C44Supra/Lily58/(commit log)

2019-08-20 Fixed gaps in copper fills
    [Lily58_Pro.kicad_pcb]
2019-08-20 Replaced SW25 with Rotary Encoder. Takes place of SW25 in matrix
    Removed the footprint for switch 25 and replaced it with an Alps EC11E encoder. Encoder outputs have been connected to A3(PF4) and A2(PF5). The switch part of the encoder connects to the old spot of SW25 in the matrix. I've used a modified version of the footprint Keeb.io made for this particular encoder and added it to the lily58 footprint library. Also plotted gerbers, stored in the "_gerbers" folder.
    [Lily58_Pro-B_Cu.gbl, Lily58_Pro-B_Mask.gbs, Lily58_Pro-B_SilkS.gbo, Lily58_Pro-Edge_Cuts.gm1, Lily58_Pro-F_Cu.gtl, Lily58_Pro-F_Mask.gts, Lily58_Pro-F_SilkS.gto, Lily58_Pro.drl]
